juamarCas/CS4270_Module/CS4270_MODULE/CS4270_MODULE/CS4270_MODULE.kicad_pcb

## KiCad design CS4270_MODULE/CS4270_MODULE/CS4270_MODULE.kicad_pcb (2023-02-23)

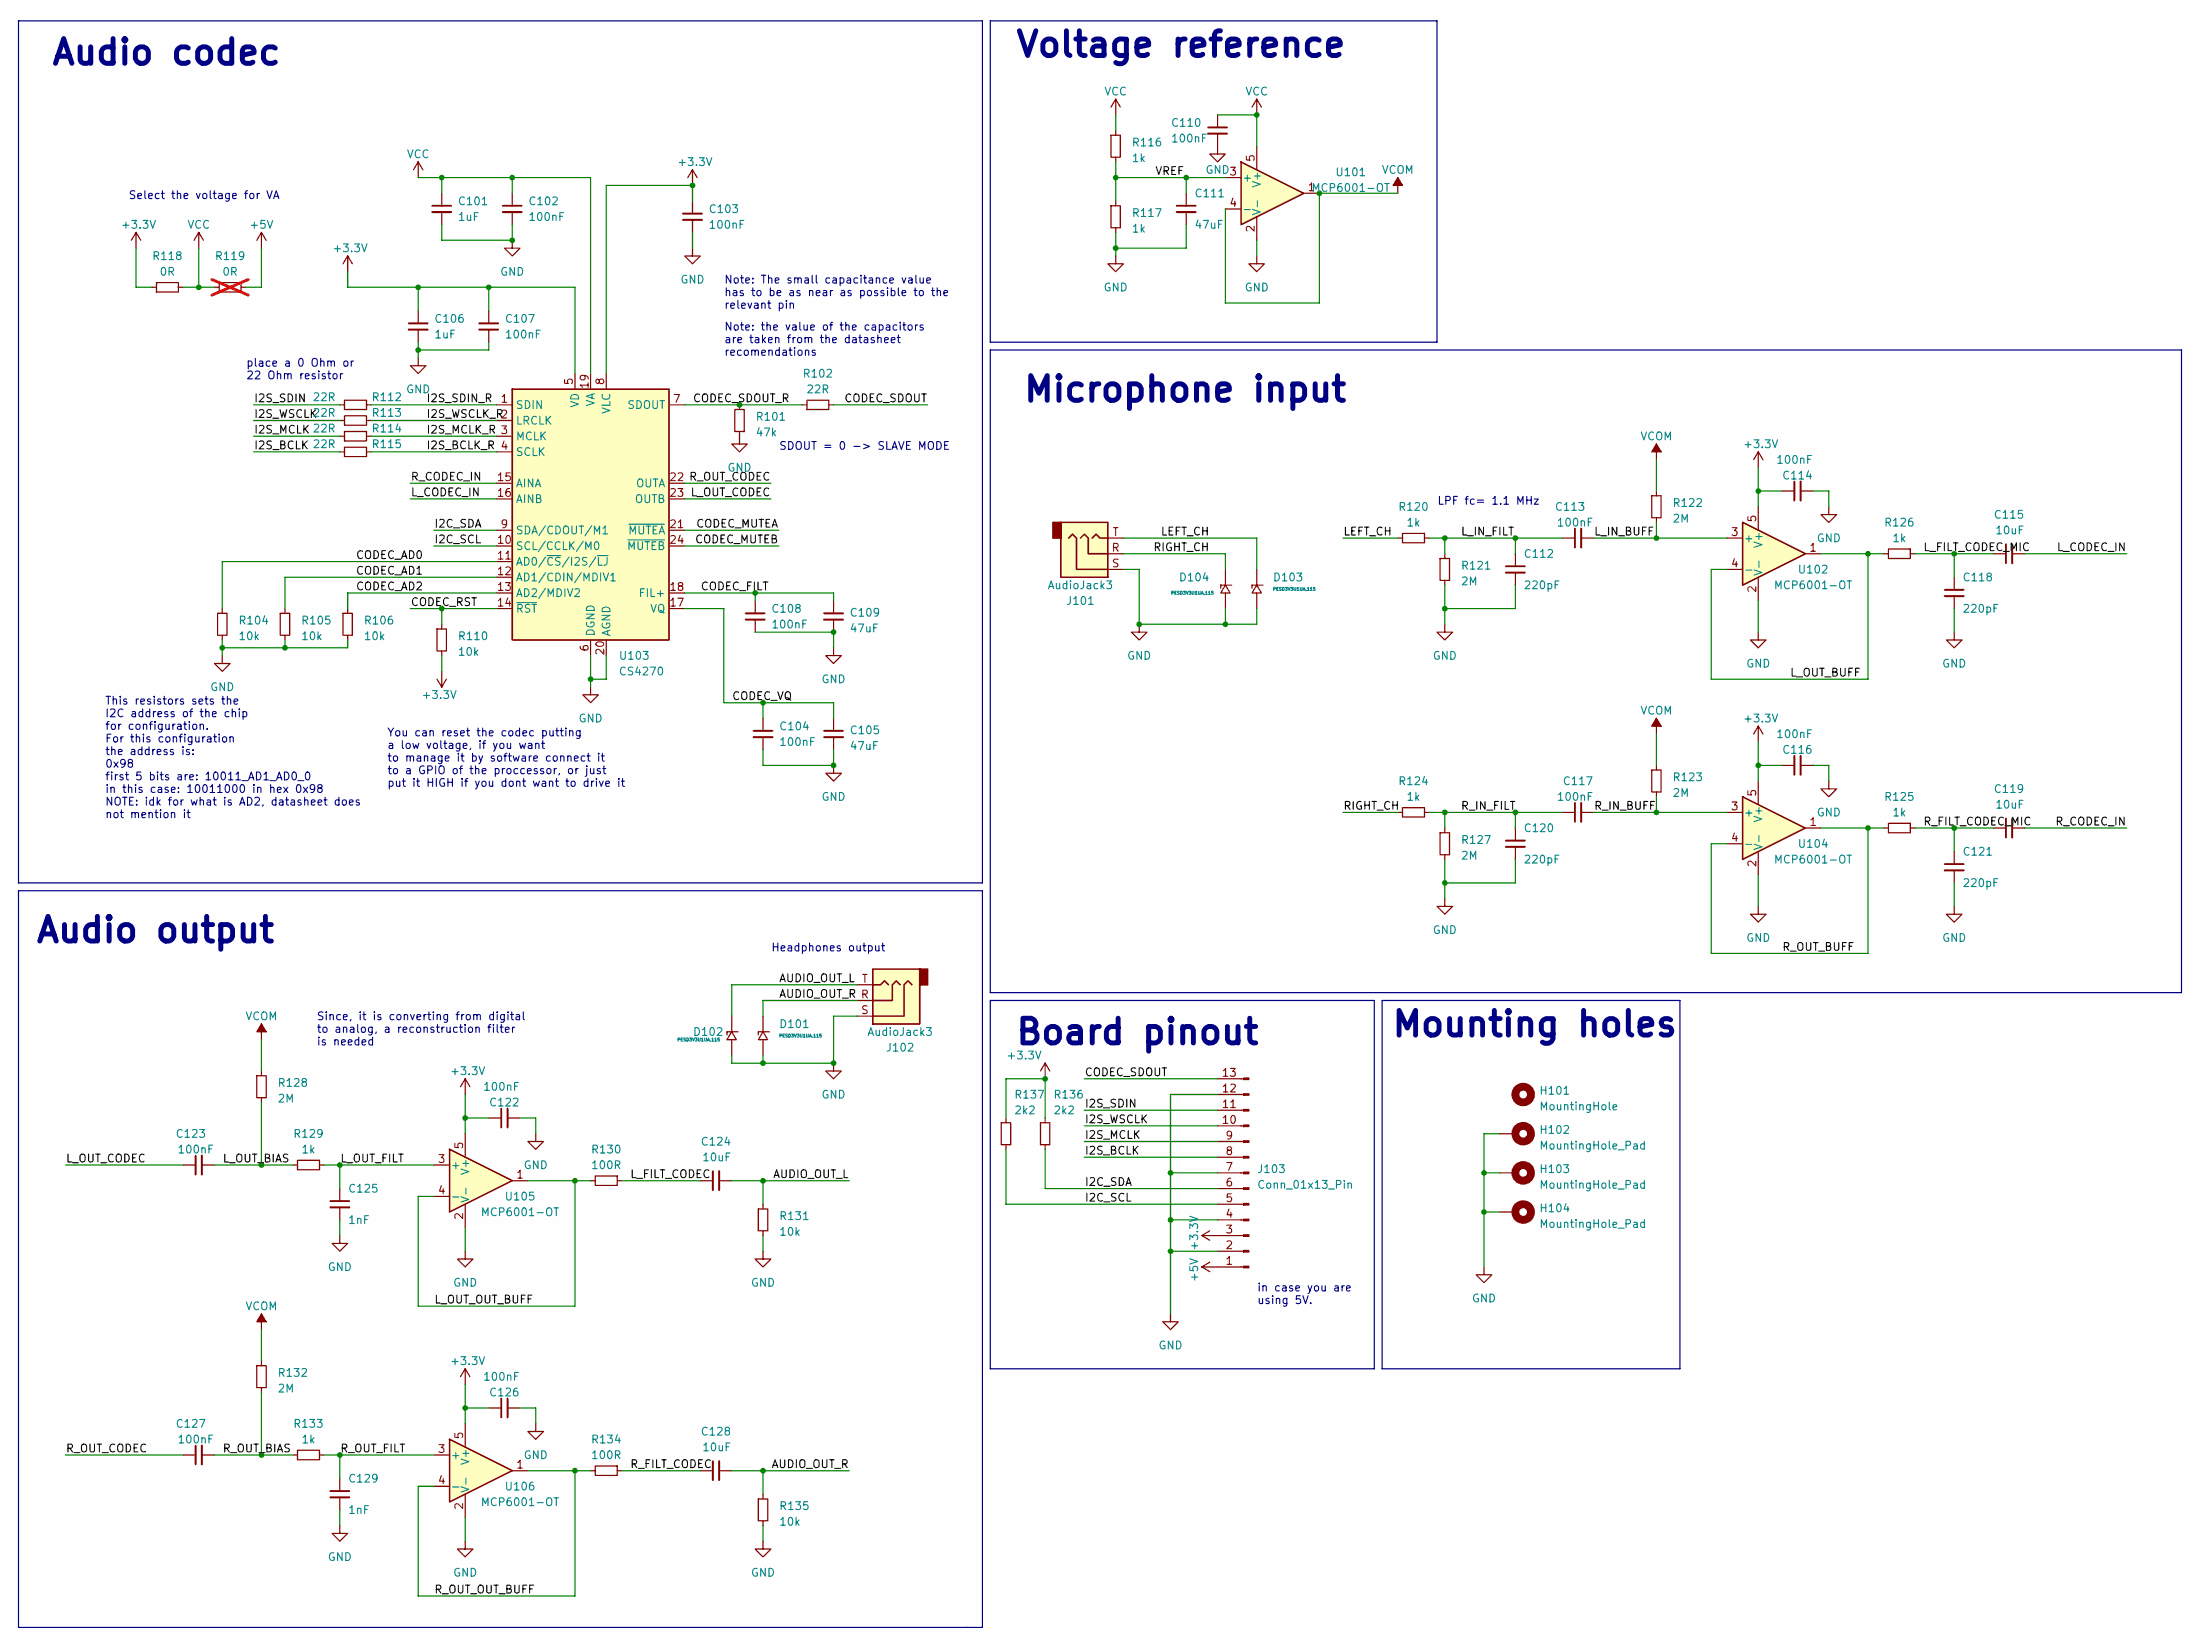
[picture p1: schematic CS4270_MODULE.kicad_sch, CS4270 Module]

Parts:
C101, C106: 1uF; C_0402_1005Metric; Mfr Part# GRM155R61E105MA12D
C102, C103, C104, C107, C108, C110, C113, C114, C116, C117, C122, C123, C126, C127: 100nF; C_0402_1005Metric; Mfr Part# C1005X7R1C104K050BC
C105, C109, C111: 47uF; C_0603_1608Metric; Mfr Part# 0603ZG474ZAT2A
C112, C118, C120, C121: 220pF; C_0603_1608Metric; Mfr Part# C0603C221G3HACTU
C115, C119, C124, C128: 10uF; C_0805_2012Metric; Mfr Part# GRM21BR61C106KE15K
C125, C129: 1nF; C_0402_1005Metric; Mfr Part# GRM1555C1H102JA1J
D101, D102, D103, D104: PESD3V3U1UA,115; SOD-323-2; Mfr Part# PESD3V3U1UA,115
H101: MountingHole; MountingHole_2.2mm_M2
H102: MountingHole_Pad; MountingHole_2.2mm_M2_Pad_TopBottom
H103, H104: MountingHole_Pad; MountingHole_2.2mm_M2_DIN965_Pad_TopBottom
J101, J102: AudioJack3; JAC_TRS_3.5mm_SMD; Mfr Part# 35RASMT2BHSNTRX
J103: Conn_01x13_Pin; PinHeader_1x13_P2.54mm_Vertical
R101: 47k; R_0603_1608Metric; Mfr Part# ERJ-3GEYJ473V
R102, R112, R113, R114, R115: 22R; R_0603_1608Metric; Mfr Part# ERJ-PA3F22R0V
R104, R105, R106, R110, R131, R135: 10k; R_0805_2012Metric; Mfr Part# CR0805-JW-103ELF
R116, R117, R120, R124, R125, R126, R129, R133: 1k; R_0603_1608Metric; Mfr Part# CR0603-FX-1001ELF
R118: 0R; R_0603_1608Metric; Mfr Part# ERJ-3GEY0R00V
R119: 0R; R_0603_1608Metric; Mfr Part# ERJ-3GEY0R00V; not fitted
R121, R122, R123, R127, R128, R132: 2M; R_0805_2012Metric; Mfr Part# RC0805JR-072M2L
R130, R134: 100R; R_0603_1608Metric; Mfr Part# CR0603-FX-1000ELF
R136, R137: 2k2; R_0805_2012Metric; Mfr Part# CR0805-JW-222ELF
U101, U102, U104, U105, U106: MCP6001-OT; SOT-23-5; Mfr Part# MCP6001UT-I/OT
U103: CS4270; TSSOP-24_4.4x7.8mm_P0.65mm; Mfr Part# CS4270-CZZ

Connections:
+3V3: C103.1, C106.1, C107.1, C114.1, C116.1, C122.1, C126.1, J103.3, R110.2, R118.1, R136.1, R137.1, U102.5 (V+), U103.5 (VD), U103.8 (VLC), U104.5 (V+), U105.5 (V+), U106.5 (V+)
+5V: J103.1, R119.2
/AUDIO_OUT_L: C124.2, D102.1 (K), J102.T, R131.1
/AUDIO_OUT_R: C128.2, D101.1 (K), J102.R, R135.1
/CODEC_AD0: R104.1, U103.11 (AD0/~CS/I2S/~LJ)
/CODEC_AD1: R105.1, U103.12 (AD1/CDIN/MDIV1)
/CODEC_AD2: R106.1, U103.13 (AD2/MDIV2)
/CODEC_FILT: C108.1, C109.1, U103.18 (FIL+)
/CODEC_MUTEA: U103.21 (~MUTEA)
/CODEC_MUTEB: U103.24 (~MUTEB)
/CODEC_RST: R110.1, U103.14 (~RST)
/CODEC_SDOUT: J103.13, R102.2
/CODEC_SDOUT_R: R101.2, R102.1, U103.7 (SDOUT)
/CODEC_VQ: C104.1, C105.1, U103.17 (VQ)
/I2C_SCL: J103.5, R137.2, U103.10 (SCL/CCLK/M0)
/I2C_SDA: J103.6, R136.2, U103.9 (SDA/CDOUT/M1)
/I2S_BCLK: J103.8, R115.1
/I2S_BCLK_R: R115.2, U103.4 (SCLK)
/I2S_MCLK: J103.9, R114.1
/I2S_MCLK_R: R114.2, U103.3 (MCLK)
/I2S_SDIN: J103.11, R112.1
/I2S_SDIN_R: R112.2, U103.1 (SDIN)
/I2S_WSCLK: J103.10, R113.1
/I2S_WSCLK_R: R113.2, U103.2 (LRCLK)
/LEFT_CH: D103.1 (K), J101.T, R120.2
/L_CODEC_IN: C115.2, U103.16 (AINB)
/L_FILT_CODEC: C124.1, R130.1
/L_FILT_CODEC_MIC: C115.1, C118.1, R126.1
/L_IN_BUFF: C113.2, R122.2, U102.3 (+)
/L_IN_FILT: C112.1, C113.1, R120.1, R121.1
/L_OUT_BIAS: C123.2, R128.2, R129.2
/L_OUT_BUFF: R126.2, U102.1, U102.4 (-)
/L_OUT_CODEC: C123.1, U103.23 (OUTB)
/L_OUT_FILT: C125.1, R129.1, U105.3 (+)
/L_OUT_OUT_BUFF: R130.2, U105.1, U105.4 (-)
/RIGHT_CH: D104.1 (K), J101.R, R124.2
/R_CODEC_IN: C119.2, U103.15 (AINA)
/R_FILT_CODEC: C128.1, R134.1
/R_FILT_CODEC_MIC: C119.1, C121.1, R125.1
/R_IN_BUFF: C117.2, R123.2, U104.3 (+)
/R_IN_FILT: C117.1, C120.1, R124.1, R127.1
/R_OUT_BIAS: C127.2, R132.2, R133.2
/R_OUT_BUFF: R125.2, U104.1, U104.4 (-)
/R_OUT_CODEC: C127.1, U103.22 (OUTA)
/R_OUT_FILT: C129.1, R133.1, U106.3 (+)
/R_OUT_OUT_BUFF: R134.2, U106.1, U106.4 (-)
/VREF: C111.1, R116.2, R117.1, U101.3 (+)
GND: C101.2, C102.2, C103.2, C104.2, C105.2, C106.2, C107.2, C108.2, C109.2, C110.2, C111.2, C112.2, C114.2, C116.2, C118.2, C120.2, C121.2, C122.2, C125.2, C126.2, C129.2, D101.2 (A), D102.2 (A), D103.2 (A), D104.2 (A), H102.1, H103.1, H104.1, J101.S, J102.S, J103.2, J103.4, J103.7, J103.12, R101.1, R104.2, R105.2, R106.2, R117.2, R121.2, R127.2, R131.2, R135.2, U101.2 (V-), U102.2 (V-), U103.6 (DGND), U103.20 (AGND), U104.2 (V-), U105.2 (V-), U106.2 (V-)
VCC: C101.1, C102.1, C110.1, R116.1, R118.2, R119.1, U101.5 (V+), U103.19 (VA)
VCOM: R122.1, R123.1, R128.1, R132.1, U101.1, U101.4 (-)

Notes on the sheet:
Audio output
SDOUT = 0 -> SLAVE MODE
You can reset the codec putting a low voltage, if you want to manage it by software connect it to a GPIO of the proccessor, or just put it HIGH if you dont want to drive it
LPF fc= 1.1 MHz
Headphones output
Since, it is converting from digital to analog, a reconstruction filter is needed
Note: The small capacitance value has to be as near as possible to the relevant pin
Voltage reference
place a 0 Ohm or 22 Ohm resistor
in case you are using 5V.
Mounting holes
Select the voltage for VA
Note: the value of the capacitors are taken from the datasheet recomendations
Board pinout
Audio codec
Microphone input
This resistors sets the I2C address of the chip for configuration. For this configuration the address is: 0x98 first 5 bits are: 10011_AD1_AD0_0 in this case: 10011000 in hex 0x98 NOTE: idk for what is AD2, datasheet does not mention it

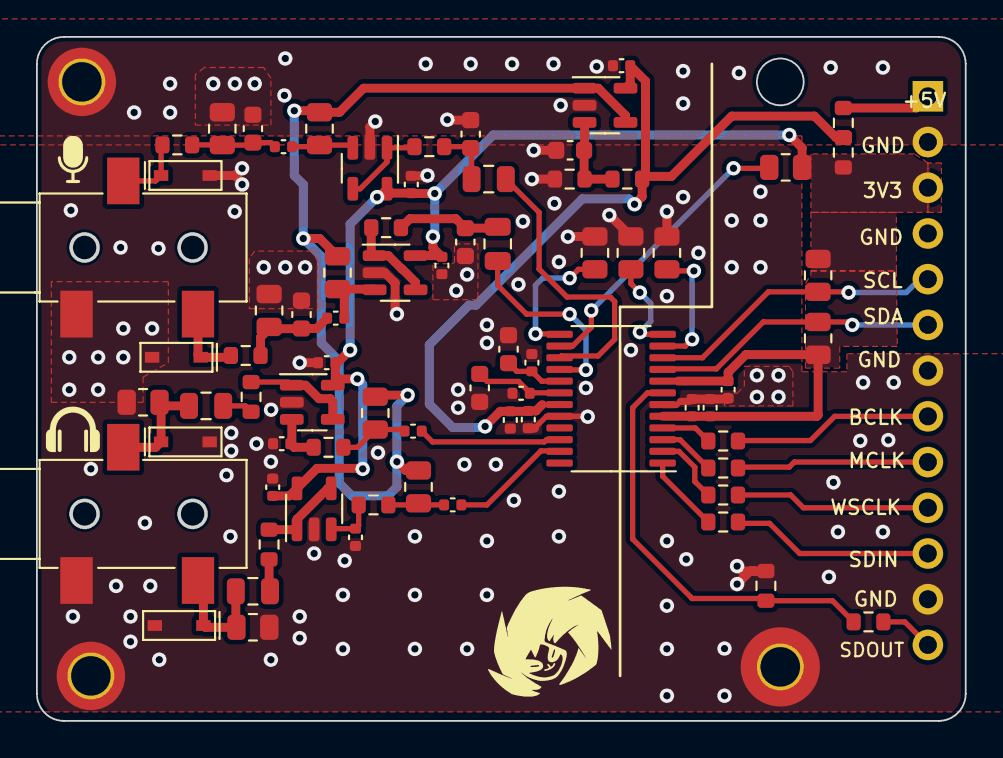
[picture p2: board CS4270_MODULE.kicad_pcb from above]

Board: 4 copper layers, 51.6 x 38.0 mm, 77 parts (1 on the bottom side), 48 nets.
